brentl06/FAST_accelerator/camera_accelerator_schematic/camera_accelerator_schematic.kicad_sch

## KiCad design camera_accelerator_schematic/camera_accelerator_schematic.kicad_sch (2026-09-30)

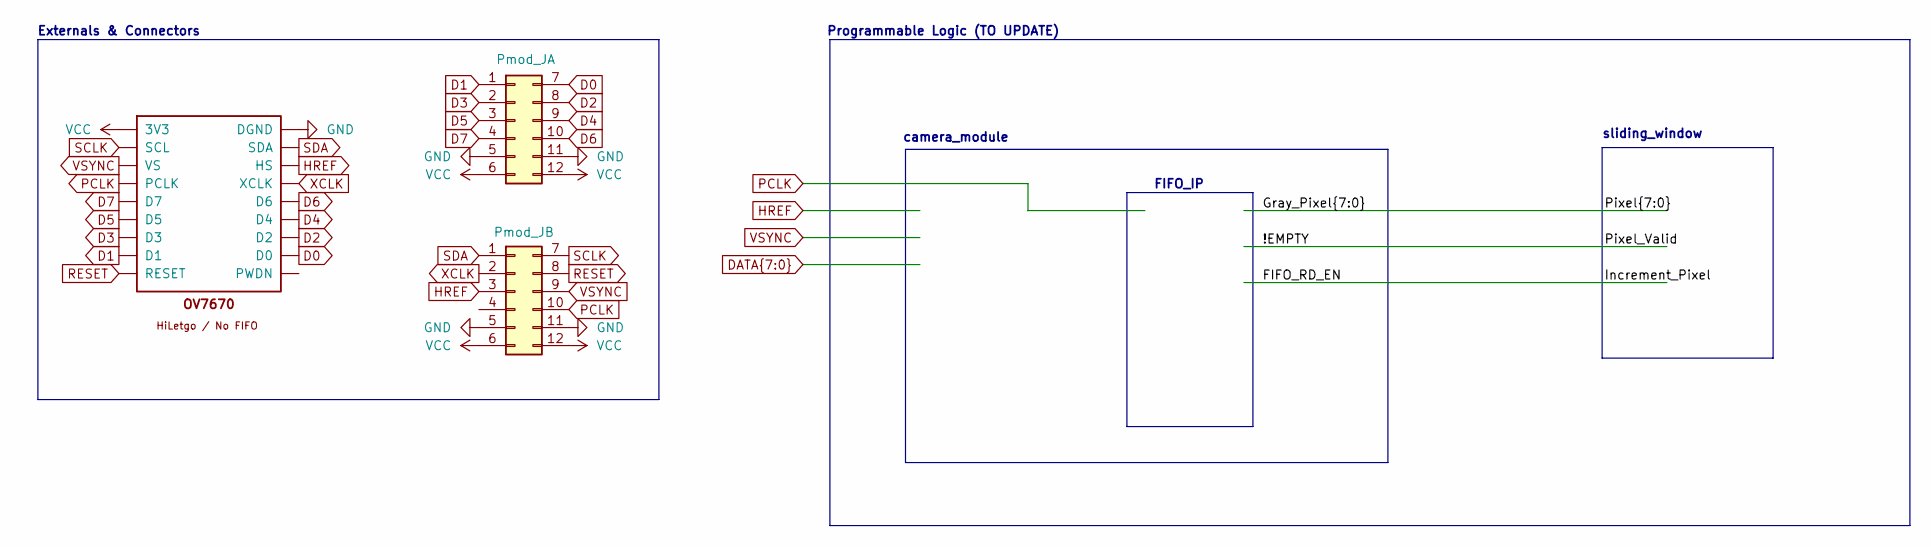
[picture p1: schematic camera_accelerator_schematic.kicad_sch]

Parts:
CAM1: OV7670_HiLetgo_2x9
Pmod_JA: Conn_02x06_Top_Bottom
Pmod_JB: Conn_02x06_Top_Bottom

Connections:
D0: CAM1.16 (D0), Pmod_JA.7
D1: CAM1.15 (D1), Pmod_JA.1
D2: CAM1.14 (D2), Pmod_JA.8
D3: CAM1.13 (D3), Pmod_JA.2
D4: CAM1.12 (D4), Pmod_JA.9
D5: CAM1.11 (D5), Pmod_JA.3
D6: CAM1.10 (D6), Pmod_JA.10
D7: CAM1.9 (D7), Pmod_JA.4
GND: CAM1.2 (DGND), Pmod_JA.5, Pmod_JA.11, Pmod_JB.5, Pmod_JB.11
HREF: CAM1.6 (HS), Pmod_JB.3
PCLK: CAM1.7 (PCLK), Pmod_JB.10
RESET: CAM1.17 (RESET), Pmod_JB.8
SCLK: CAM1.3 (SCL), Pmod_JB.7
SDA: CAM1.4 (SDA), Pmod_JB.1
VCC: CAM1.1 (3V3), Pmod_JA.6, Pmod_JA.12, Pmod_JB.6, Pmod_JB.12
VSYNC: CAM1.5 (VS), Pmod_JB.9
XCLK: CAM1.8 (XCLK), Pmod_JB.2

Notes on the sheet:
camera_module
Externals & Connectors
Programmable Logic (TO UPDATE)
FIFO_IP
sliding_window
