brentl06/FAST_accelerator/camera_accelerator.srcs/sources_1/new/orb_pattern.v

// ORB pattern from OpenCV 4.12.0 modules/features2d/src/orb.cpp.
/*********************************************************************
* Software License Agreement (BSD License)
*
*  Copyright (c) 2009, Willow Garage, Inc.
*  All rights reserved.
*
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
*   * Redistributions of source code must retain the above copyright
*     notice, this list of conditions and the following disclaimer.
*   * Redistributions in binary form must reproduce the above
*     copyright notice, this list of conditions and the following
*     disclaimer in the documentation and/or other materials provided
*     with the distribution.
*   * Neither the name of the Willow Garage nor the names of its
*     contributors may be used to endorse or promote products derived
*     from this software without specific prior written permission.
*
*  THIS SOFTWARE IS PROVIDED BY THE COPYRIGHT HOLDERS AND CONTRIBUTORS
*  "AS IS" AND ANY EXPRESS OR IMPLIED WARRANTIES, INCLUDING, BUT NOT
*  LIMITED TO, THE IMPLIED WARRANTIES OF MERCHANTABILITY AND FITNESS
*  FOR A PARTICULAR PURPOSE ARE DISCLAIMED. IN NO EVENT SHALL THE
*  COPYRIGHT OWNER OR CONTRIBUTORS BE LIABLE FOR ANY DIRECT, INDIRECT,
*  INCIDENTAL, SPECIAL, EXEMPLARY, OR CONSEQUENTIAL DAMAGES (INCLUDING,
*  BUT NOT LIMITED TO, PROCUREMENT OF SUBSTITUTE GOODS OR SERVICES;
*  LOSS OF USE, DATA, OR PROFITS; OR BUSINESS INTERRUPTION) HOWEVER
*  CAUSED AND ON ANY THEORY OF LIABILITY, WHETHER IN CONTRACT, STRICT
*  LIABILITY, OR TORT (INCLUDING NEGLIGENCE OR OTHERWISE) ARISING IN
*  ANY WAY OUT OF THE USE OF THIS SOFTWARE, EVEN IF ADVISED OF THE
*  POSSIBILITY OF SUCH DAMAGE.
*********************************************************************/
module orb_pattern(input wire [8:0] index,
    output reg signed [4:0] x, output reg signed [4:0] y);
    always @* begin
        case (index)
            9'd0: begin x = 5'sd8; y = -5'sd3; end
            9'd1: begin x = 5'sd9; y = 5'sd5; end
            9'd2: begin x = 5'sd4; y = 5'sd2; end
            9'd3: begin x = 5'sd7; y = -5'sd12; end
            9'd4: begin x = -5'sd11; y = 5'sd9; end
            9'd5: begin x = -5'sd8; y = 5'sd2; end
            9'd6: begin x = 5'sd7; y = -5'sd12; end
            9'd7: begin x = 5'sd12; y = -5'sd13; end
            9'd8: begin x = 5'sd2; y = -5'sd13; end
            9'd9: begin x = 5'sd2; y = 5'sd12; end
            9'd10: begin x = 5'sd1; y = -5'sd7; end
            9'd11: begin x = 5'sd1; y = 5'sd6; end
            9'd12: begin x = -5'sd2; y = -5'sd10; end
            9'd13: begin x = -5'sd2; y = -5'sd4; end
            9'd14: begin x = -5'sd13; y = -5'sd13; end
            9'd15: begin x = -5'sd11; y = -5'sd8; end
            9'd16: begin x = -5'sd13; y = -5'sd3; end
            9'd17: begin x = -5'sd12; y = -5'sd9; end
            9'd18: begin x = 5'sd10; y = 5'sd4; end
            9'd19: begin x = 5'sd11; y = 5'sd9; end
            9'd20: begin x = -5'sd13; y = -5'sd8; end
            9'd21: begin x = -5'sd8; y = -5'sd9; end
            9'd22: begin x = -5'sd11; y = 5'sd7; end
            9'd23: begin x = -5'sd9; y = 5'sd12; end
            9'd24: begin x = 5'sd7; y = 5'sd7; end
            9'd25: begin x = 5'sd12; y = 5'sd6; end
            9'd26: begin x = -5'sd4; y = -5'sd5; end
            9'd27: begin x = -5'sd3; y = 5'sd0; end
            9'd28: begin x = -5'sd13; y = 5'sd2; end
            9'd29: begin x = -5'sd12; y = -5'sd3; end
            9'd30: begin x = -5'sd9; y = 5'sd0; end
            9'd31: begin x = -5'sd7; y = 5'sd5; end
            9'd32: begin x = 5'sd12; y = -5'sd6; end
            9'd33: begin x = 5'sd12; y = -5'sd1; end
            9'd34: begin x = -5'sd3; y = 5'sd6; end
            9'd35: begin x = -5'sd2; y = 5'sd12; end
            9'd36: begin x = -5'sd6; y = -5'sd13; end
            9'd37: begin x = -5'sd4; y = -5'sd8; end
            9'd38: begin x = 5'sd11; y = -5'sd13; end
            9'd39: begin x = 5'sd12; y = -5'sd8; end
            9'd40: begin x = 5'sd4; y = 5'sd7; end
            9'd41: begin x = 5'sd5; y = 5'sd1; end
            9'd42: begin x = 5'sd5; y = -5'sd3; end
            9'd43: begin x = 5'sd10; y = -5'sd3; end
            9'd44: begin x = 5'sd3; y = -5'sd7; end
            9'd45: begin x = 5'sd6; y = 5'sd12; end
            9'd46: begin x = -5'sd8; y = -5'sd7; end
            9'd47: begin x = -5'sd6; y = -5'sd2; end
            9'd48: begin x = -5'sd2; y = 5'sd11; end
            9'd49: begin x = -5'sd1; y = -5'sd10; end
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
            9'd508: begin x = 5'sd7; y = 5'sd0; end
            9'd509: begin x = 5'sd12; y = -5'sd2; end
            9'd510: begin x = -5'sd1; y = -5'sd6; end
            9'd511: begin x = 5'sd0; y = -5'sd11; end
            default: begin x = 0; y = 0; end
        endcase
    end
endmodule

// Q10 unit vectors. Bins advance clockwise in image coordinates (y down).
module orb_trig(input wire [4:0] bin,
    output reg signed [11:0] cosine, output reg signed [11:0] sine);
    always @* begin
        case (bin)
            5'd0: begin cosine = 12'sd1024; sine = 12'sd0; end
            5'd1: begin cosine = 12'sd1004; sine = 12'sd200; end
            5'd2: begin cosine = 12'sd946; sine = 12'sd392; end
            5'd3: begin cosine = 12'sd851; sine = 12'sd569; end
            5'd4: begin cosine = 12'sd724; sine = 12'sd724; end
            5'd5: begin cosine = 12'sd569; sine = 12'sd851; end
            5'd6: begin cosine = 12'sd392; sine = 12'sd946; end
            5'd7: begin cosine = 12'sd200; sine = 12'sd1004; end
            5'd8: begin cosine = 12'sd0; sine = 12'sd1024; end
            5'd9: begin cosine = -12'sd200; sine = 12'sd1004; end
            5'd10: begin cosine = -12'sd392; sine = 12'sd946; end
            5'd11: begin cosine = -12'sd569; sine = 12'sd851; end
            5'd12: begin cosine = -12'sd724; sine = 12'sd724; end
            5'd13: begin cosine = -12'sd851; sine = 12'sd569; end
            5'd14: begin cosine = -12'sd946; sine = 12'sd392; end
            5'd15: begin cosine = -12'sd1004; sine = 12'sd200; end
            5'd16: begin cosine = -12'sd1024; sine = 12'sd0; end
            5'd17: begin cosine = -12'sd1004; sine = -12'sd200; end
            5'd18: begin cosine = -12'sd946; sine = -12'sd392; end
            5'd19: begin cosine = -12'sd851; sine = -12'sd569; end
            5'd20: begin cosine = -12'sd724; sine = -12'sd724; end
            5'd21: begin cosine = -12'sd569; sine = -12'sd851; end
            5'd22: begin cosine = -12'sd392; sine = -12'sd946; end
            5'd23: begin cosine = -12'sd200; sine = -12'sd1004; end
            5'd24: begin cosine = 12'sd0; sine = -12'sd1024; end
            5'd25: begin cosine = 12'sd200; sine = -12'sd1004; end
            5'd26: begin cosine = 12'sd392; sine = -12'sd946; end
            5'd27: begin cosine = 12'sd569; sine = -12'sd851; end
            5'd28: begin cosine = 12'sd724; sine = -12'sd724; end
            5'd29: begin cosine = 12'sd851; sine = -12'sd569; end
            5'd30: begin cosine = 12'sd946; sine = -12'sd392; end
            5'd31: begin cosine = 12'sd1004; sine = -12'sd200; end
            default: begin cosine = 12'sd1024; sine = 0; end
        endcase
    end
endmodule
