brentl06/FAST_accelerator/camera_accelerator.srcs/sources_1/new/frame_buffer.v

`timescale 1ns / 1ps
//////////////////////////////////////////////////////////////////////////////////
// Company: 
// Engineer: 
// 
// Create Date: 09/24/2026 09:44:16 PM
// Design Name: 
// Module Name: frame_buffer
// Project Name: 
// Target Devices: 
// Tool Versions: 
// Description: 
// 
// Dependencies: 
// 
// Revision:
// Revision 0.01 - File Created
// Additional Comments:
// 
//////////////////////////////////////////////////////////////////////////////////

// FRAME BUFFER TO INTERFACE WITH PROCESSING PIPELINE AND VGA DRIVER

module frame_buffer#(
        parameter FRAME_WIDTH = 640,
        parameter FRAME_HEIGHT = 480,
        parameter DATA_WIDTH = 4
    )( 
        write_clk, write_x, write_y, data_in, write_en,
        sys_read_x, sys_read_y, sys_read_en,
        sys_data_out, sys_read_valid, sys_read_ready,
        read_clk, read_x, read_y, read_en,
        data_out, reset
    );
    input reset;
    
    // SYS write side
    input write_clk;
    input [9:0] write_x;
    input [8:0] write_y;
    input [DATA_WIDTH-1:0] data_in;
    input write_en;

    // System-clock read side. This shares the BRAM port used by writes, so a
    // request is accepted only while sys_read_ready is high. With no writes,
    // data is returned one cycle after the accepting edge (two pipeline stages).
    // The intended
    // ping-pong use is to write one framebuffer while reading the other.
    input [9:0] sys_read_x;
    input [8:0] sys_read_y;
    input       sys_read_en;
    output reg [DATA_WIDTH-1:0] sys_data_out;
    output reg       sys_read_valid;
    output wire      sys_read_ready;
    
    // VGA read side 
    input read_clk;
    input [9:0] read_x;
    input [8:0] read_y; 
    input read_en;
    
    output reg [DATA_WIDTH-1:0] data_out;
    
    // INTERNAL REGs and WIRES
    localparam FRAME_SIZE = FRAME_WIDTH * FRAME_HEIGHT;
    wire [18:0] rd_addr;
    wire [18:0] wr_addr;
    wire [18:0] sys_rd_addr;
    reg [18:0] sys_rd_addr_q;
    reg sys_read_pending;
    wire valid_rd_addr;
    wire valid_wr_addr;
    wire valid_sys_rd_addr;
    reg [18:0] wr_addr_q;
    reg [DATA_WIDTH-1:0] wr_data_q;
    reg        wr_en_q;
    wire       port_a_read_en;
    wire       port_a_en;
    wire       port_a_write_en;
    wire [18:0] port_a_addr;
    
    (* ram_style = "block" *)
    reg [DATA_WIDTH-1:0] memory [0:FRAME_SIZE-1];
    integer init_x;
    integer init_y;

    // Give the display deterministic black pixels before camera processing
    // begins. In particular, the Sobel pipeline intentionally never writes the
    // outer one-pixel border.
    initial begin
        for (init_y = 0; init_y < FRAME_HEIGHT; init_y = init_y + 1) begin
            for (init_x = 0; init_x < FRAME_WIDTH; init_x = init_x + 1)
                memory[(init_y * FRAME_WIDTH) + init_x] = {DATA_WIDTH{1'b0}};
        end
    end
    
    assign valid_rd_addr = (read_x < FRAME_WIDTH) & (read_y < FRAME_HEIGHT);
    assign valid_wr_addr = (write_x < FRAME_WIDTH) & (write_y < FRAME_HEIGHT);
    assign valid_sys_rd_addr = (sys_read_x < FRAME_WIDTH) &
                               (sys_read_y < FRAME_HEIGHT);
    
    assign rd_addr = (read_y * FRAME_WIDTH) + read_x;
    assign wr_addr = (write_y * FRAME_WIDTH) + write_x;
    assign sys_rd_addr = (sys_read_y * FRAME_WIDTH) + sys_read_x;
    // One-entry request queue pipelines address arithmetic before BRAM decode.
    // A pending read survives any intervening writes. When the port is free,
    // consume it and accept the next request in the same cycle.
    assign sys_read_ready = !reset && (!sys_read_pending || !wr_en_q);
    assign port_a_read_en = sys_read_pending && !wr_en_q;
    assign port_a_en = wr_en_q | port_a_read_en;
    assign port_a_write_en = wr_en_q;
    assign port_a_addr = wr_en_q ? wr_addr_q : sys_rd_addr_q;
    
    // Reading logic
    always @(posedge read_clk) 
    begin: READ_PROCESS
        if (reset) 
            data_out <= 0;
        else if (read_en & valid_rd_addr) begin
            data_out <= memory[rd_addr];
        end
    end
    
    // Pipeline the complete write request before it reaches the framebuffer.
    // This separates the y * FRAME_WIDTH + x address calculation from the
    // BRAM bank decode and write-enable path while preserving one write per
    // clock throughput.
    always @(posedge write_clk)
    begin: WRITE_PROCESS
        if (reset) begin
            wr_addr_q <= 19'd0;
            wr_data_q <= {DATA_WIDTH{1'b0}};
            wr_en_q   <= 1'b0;
            sys_data_out   <= {DATA_WIDTH{1'b0}};
            sys_read_valid <= 1'b0;
            sys_read_pending <= 1'b0;
            sys_rd_addr_q <= 0;
        end else begin
            wr_en_q <= write_en & valid_wr_addr;
            sys_read_valid <= 1'b0;
            if (sys_read_ready) begin
                sys_read_pending <= sys_read_en && valid_sys_rd_addr;
                if (sys_read_en && valid_sys_rd_addr)
                    sys_rd_addr_q <= sys_rd_addr;
            end

            if (write_en & valid_wr_addr) begin
                wr_addr_q <= wr_addr;
                wr_data_q <= data_in;
            end

            if (port_a_en) begin
                if (port_a_write_en)
                    memory[port_a_addr] <= wr_data_q;
                else begin
                    sys_data_out   <= memory[port_a_addr];
                    sys_read_valid <= 1'b1;
                end
            end
        end
    end
    
    
endmodule
