brentl06/FAST_accelerator/camera_accelerator.srcs/constrs_1/new/nexys_a7_vga_test.xdc

## Nexys A7-100T: 100 MHz oscillator
set_property -dict { PACKAGE_PIN E3 IOSTANDARD LVCMOS33 } [get_ports { CLK100MHZ }]
create_clock -add -name sys_clk_pin -period 10.000 -waveform {0 5.000} [get_ports { CLK100MHZ }]

## Active-low CPU reset button
set_property -dict { PACKAGE_PIN C12 IOSTANDARD LVCMOS33 } [get_ports { CPU_RESETN }]

## Byte-pair selection: 0 = bytes 2/4, 1 = bytes 1/3
set_property -dict { PACKAGE_PIN J15 IOSTANDARD LVCMOS33 } [get_ports { SW0 }]

## Display selection: 0 = raw grayscale, 1 = Sobel edges
set_property -dict { PACKAGE_PIN L16 IOSTANDARD LVCMOS33 } [get_ports { SW1 }]

## FAST display selection: 1 = FAST keypoint overlay (overrides SW1)
set_property -dict { PACKAGE_PIN M13 IOSTANDARD LVCMOS33 } [get_ports { SW2 }]

## Sobel threshold selection: SW15 is MSB, SW12 is LSB; one count = 25
set_property -dict { PACKAGE_PIN H6 IOSTANDARD LVCMOS33 } [get_ports { SW12 }]
set_property -dict { PACKAGE_PIN U12 IOSTANDARD LVCMOS33 } [get_ports { SW13 }]
set_property -dict { PACKAGE_PIN U11 IOSTANDARD LVCMOS33 } [get_ports { SW14 }]
set_property -dict { PACKAGE_PIN V10 IOSTANDARD LVCMOS33 } [get_ports { SW15 }]

## Seven-segment display segments (active low)
set_property -dict { PACKAGE_PIN T10 IOSTANDARD LVCMOS33 } [get_ports { CA }]
set_property -dict { PACKAGE_PIN R10 IOSTANDARD LVCMOS33 } [get_ports { CB }]
set_property -dict { PACKAGE_PIN K16 IOSTANDARD LVCMOS33 } [get_ports { CC }]
set_property -dict { PACKAGE_PIN K13 IOSTANDARD LVCMOS33 } [get_ports { CD }]
set_property -dict { PACKAGE_PIN P15 IOSTANDARD LVCMOS33 } [get_ports { CE }]
set_property -dict { PACKAGE_PIN T11 IOSTANDARD LVCMOS33 } [get_ports { CF }]
set_property -dict { PACKAGE_PIN L18 IOSTANDARD LVCMOS33 } [get_ports { CG }]
set_property -dict { PACKAGE_PIN H15 IOSTANDARD LVCMOS33 } [get_ports { DP }]

## Seven-segment display digit enables (active low)
set_property -dict { PACKAGE_PIN J17 IOSTANDARD LVCMOS33 } [get_ports { AN[0] }]
set_property -dict { PACKAGE_PIN J18 IOSTANDARD LVCMOS33 } [get_ports { AN[1] }]
set_property -dict { PACKAGE_PIN T9  IOSTANDARD LVCMOS33 } [get_ports { AN[2] }]
set_property -dict { PACKAGE_PIN J14 IOSTANDARD LVCMOS33 } [get_ports { AN[3] }]
set_property -dict { PACKAGE_PIN P14 IOSTANDARD LVCMOS33 } [get_ports { AN[4] }]
set_property -dict { PACKAGE_PIN T14 IOSTANDARD LVCMOS33 } [get_ports { AN[5] }]
set_property -dict { PACKAGE_PIN K2  IOSTANDARD LVCMOS33 } [get_ports { AN[6] }]
set_property -dict { PACKAGE_PIN U13 IOSTANDARD LVCMOS33 } [get_ports { AN[7] }]

## OV7670 control/synchronization on Pmod JB
## JB1 / D14 is reserved for camera SDA (not yet exposed by vga_test_top).
## JB7 / E16 is reserved for camera SCLK (not yet exposed by vga_test_top).
set_property -dict { PACKAGE_PIN H16 IOSTANDARD LVCMOS33 } [get_ports { CAM_PCLK }]
set_property -dict { PACKAGE_PIN G16 IOSTANDARD LVCMOS33 } [get_ports { CAM_HREF }]
set_property -dict { PACKAGE_PIN F13 IOSTANDARD LVCMOS33 } [get_ports { CAM_RESET }]
set_property -dict { PACKAGE_PIN G13 IOSTANDARD LVCMOS33 } [get_ports { CAM_VSYNC }]
set_property -dict { PACKAGE_PIN F16 IOSTANDARD LVCMOS33 } [get_ports { CAM_XCLK }]
create_clock -name camera_pclk -period 40.000 -waveform {0 20.000} [get_ports { CAM_PCLK }]

## OV7670 D1/D3/D5/D7 on JA1-JA4; D0/D2/D4/D6 on JA7-JA10
set_property -dict { PACKAGE_PIN D17 IOSTANDARD LVCMOS33 } [get_ports { CAM_DATA[0] }]
set_property -dict { PACKAGE_PIN C17 IOSTANDARD LVCMOS33 } [get_ports { CAM_DATA[1] }]
set_property -dict { PACKAGE_PIN E17 IOSTANDARD LVCMOS33 } [get_ports { CAM_DATA[2] }]
set_property -dict { PACKAGE_PIN D18 IOSTANDARD LVCMOS33 } [get_ports { CAM_DATA[3] }]
set_property -dict { PACKAGE_PIN F18 IOSTANDARD LVCMOS33 } [get_ports { CAM_DATA[4] }]
set_property -dict { PACKAGE_PIN E18 IOSTANDARD LVCMOS33 } [get_ports { CAM_DATA[5] }]
set_property -dict { PACKAGE_PIN G18 IOSTANDARD LVCMOS33 } [get_ports { CAM_DATA[6] }]
set_property -dict { PACKAGE_PIN G17 IOSTANDARD LVCMOS33 } [get_ports { CAM_DATA[7] }]

## VGA red DAC
set_property -dict { PACKAGE_PIN A3 IOSTANDARD LVCMOS33 } [get_ports { VGA_R[0] }]
set_property -dict { PACKAGE_PIN B4 IOSTANDARD LVCMOS33 } [get_ports { VGA_R[1] }]
set_property -dict { PACKAGE_PIN C5 IOSTANDARD LVCMOS33 } [get_ports { VGA_R[2] }]
set_property -dict { PACKAGE_PIN A4 IOSTANDARD LVCMOS33 } [get_ports { VGA_R[3] }]

## VGA green DAC
set_property -dict { PACKAGE_PIN C6 IOSTANDARD LVCMOS33 } [get_ports { VGA_G[0] }]
set_property -dict { PACKAGE_PIN A5 IOSTANDARD LVCMOS33 } [get_ports { VGA_G[1] }]
set_property -dict { PACKAGE_PIN B6 IOSTANDARD LVCMOS33 } [get_ports { VGA_G[2] }]
set_property -dict { PACKAGE_PIN A6 IOSTANDARD LVCMOS33 } [get_ports { VGA_G[3] }]

## VGA blue DAC
set_property -dict { PACKAGE_PIN B7 IOSTANDARD LVCMOS33 } [get_ports { VGA_B[0] }]
set_property -dict { PACKAGE_PIN C7 IOSTANDARD LVCMOS33 } [get_ports { VGA_B[1] }]
set_property -dict { PACKAGE_PIN D7 IOSTANDARD LVCMOS33 } [get_ports { VGA_B[2] }]
set_property -dict { PACKAGE_PIN D8 IOSTANDARD LVCMOS33 } [get_ports { VGA_B[3] }]

## VGA synchronization
set_property -dict { PACKAGE_PIN B11 IOSTANDARD LVCMOS33 } [get_ports { VGA_HS }]
set_property -dict { PACKAGE_PIN B12 IOSTANDARD LVCMOS33 } [get_ports { VGA_VS }]

## 25 MHz VGA pixel clock generated by the divide-by-four register
create_generated_clock -name vga_pixel_clk -source [get_ports { CLK100MHZ }] -divide_by 4 [get_pins { vga_clock_buffer/O }]
