brentl06/FAST_accelerator/(commit log)

2026-09-20 sobel filter v1 + updated tb for window -> sobel
2026-09-28 vga_driver update + created frame_buffer
2026-09-29 working cam input to vga ouput
    [camera_accelerator_schematic.kicad_sch]
2026-09-30 full cam -> processing_pipeline -> vga
    [camera_accelerator_schematic.kicad_sch]
2026-09-30 update README
    added details of current architecture
2026-10-01 Add FAST-9 corner detector with 3x3 non-max suppression
    - line_window: generic NxN streaming window, line buffers packed in one
    BRAM word per column, coordinates carried as pipeline tags
    - fast_score: pipelined FAST-9 segment test and corner score
    - fast_nms: 3x3 non-maximum suppression (strict >, as in OpenCV)
    - fast_detector / fast_pipeline_top: full detector, framebuffer overlay,
    keypoint stream and per-frame keypoint count
    - SW2 selects FAST overlay mode; 7-seg shows threshold and keypoints/frame
    - tools/fast_check.py: Icarus testbench checked against OpenCV FAST and a
    brute-force NumPy FAST-9 (positions and scores); line_window_tb checks
    every window element
